puj24/EDL_TUE16/PID_Tuning/pocket-pcr.jpeg

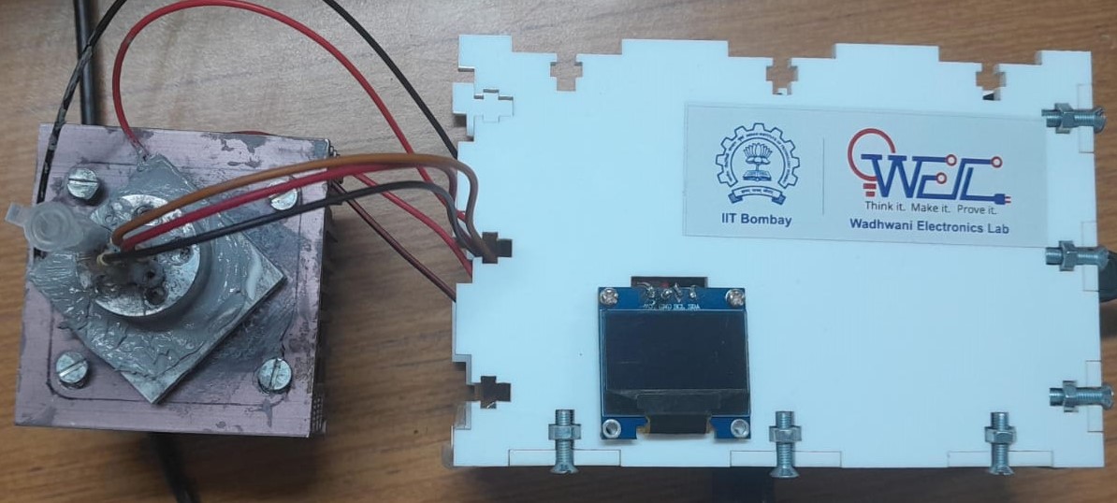
PID_Tuning/pocket-pcr.jpeg
