puj24/EDL_TUE16/Datasheets/Monochrome-OLED-display-2D-model.jpg

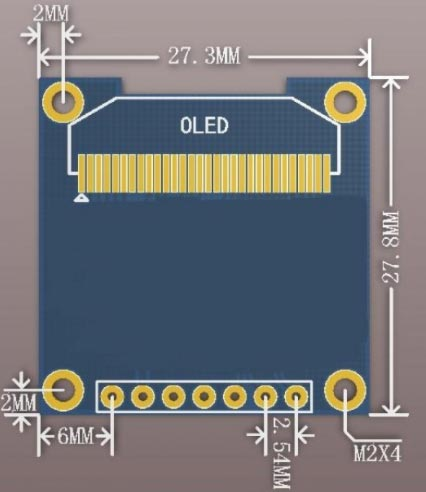
Datasheets/Monochrome-OLED-display-2D-model.jpg
