puj24/EDL_TUE16/CAD/LM35DZ.JPG

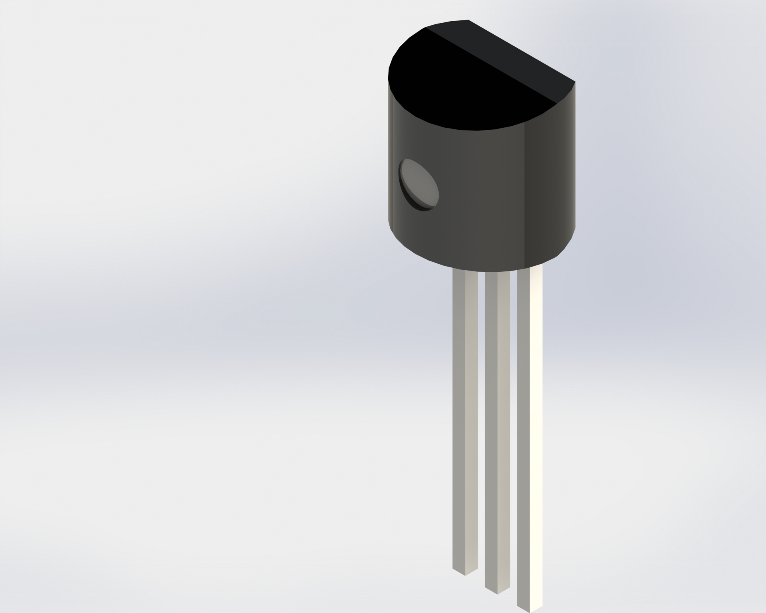
CAD/LM35DZ.JPG
