puj24/EDL_TUE16/Datasheets/Footprints-OLED128W_dims.jpg

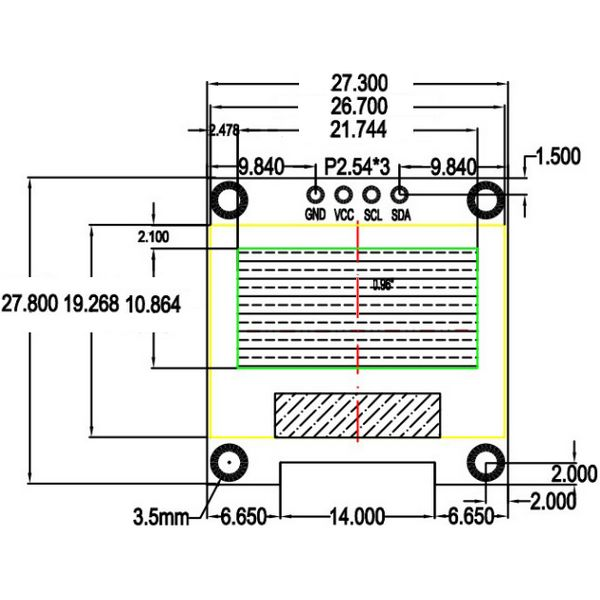
Datasheets/Footprints-OLED128W_dims.jpg
