puj24/EDL_TUE16/GANTT CHART.png

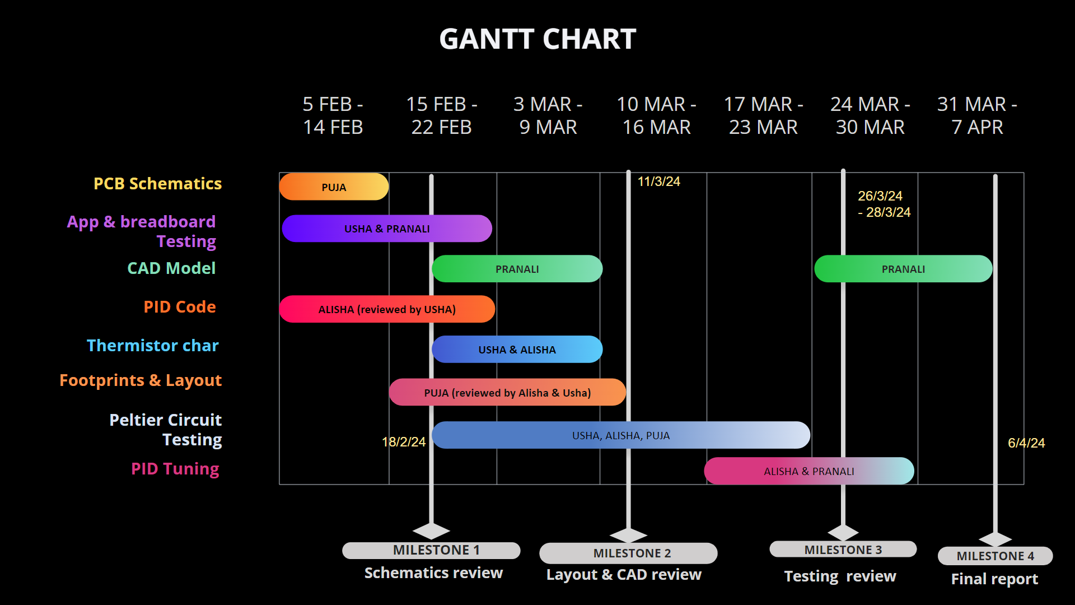
GANTT CHART.png
