puj24/EDL_TUE16/PCB_placement.png

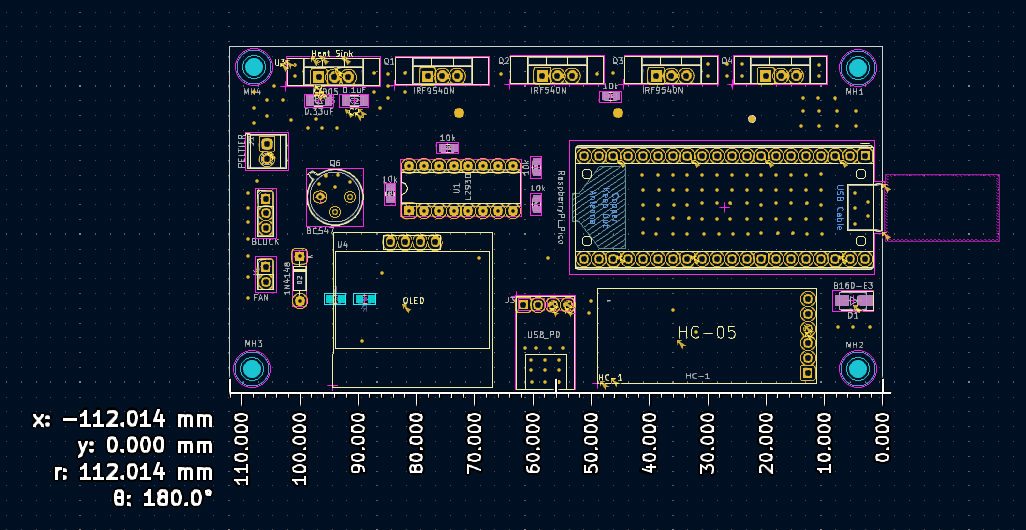
PCB_placement.png
