puj24/EDL_TUE16/CAD/vial 0.2ml.SLDPRT

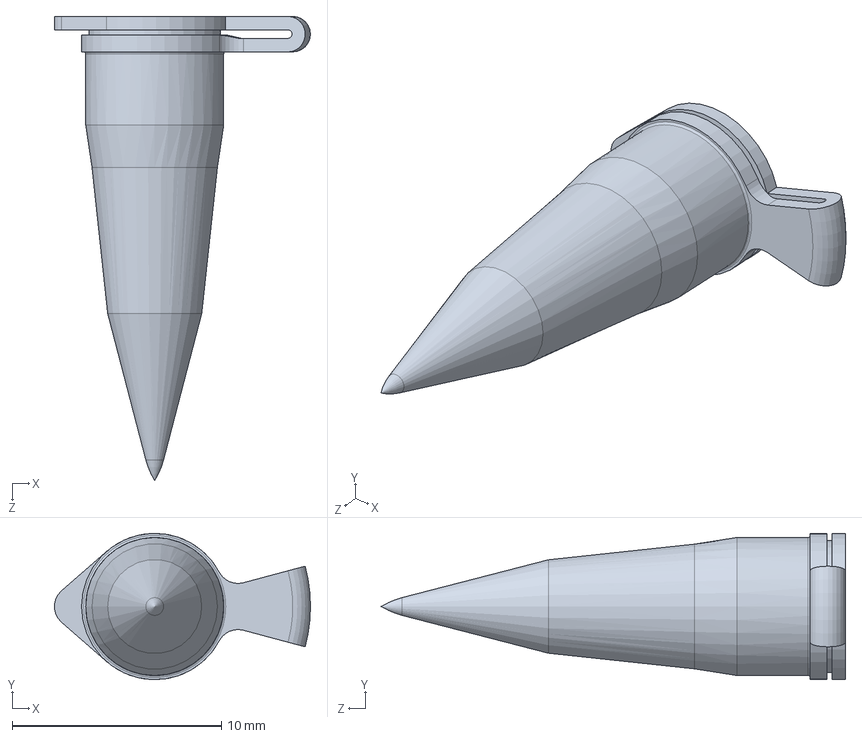
[picture p23: CAD file, 2024-06-16]
CAD/vial 0.2ml.SLDPRT
12.2 x 7.00 x 22.2 mm
