puj24/EDL_TUE16/CAD/box v4.dxf

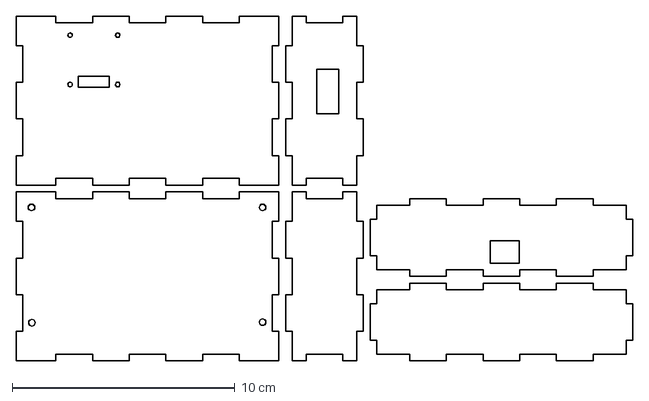
[picture p24: CAD file, 2024-06-16]
CAD/box v4.dxf
27.7 x 15.5 cm
