puj24/EDL_TUE16/(list of files, cad)

Other CAD files:
CAD/PCR_Heater v4.f3d
