puj24/EDL_TUE16/PID_Tuning/1.png

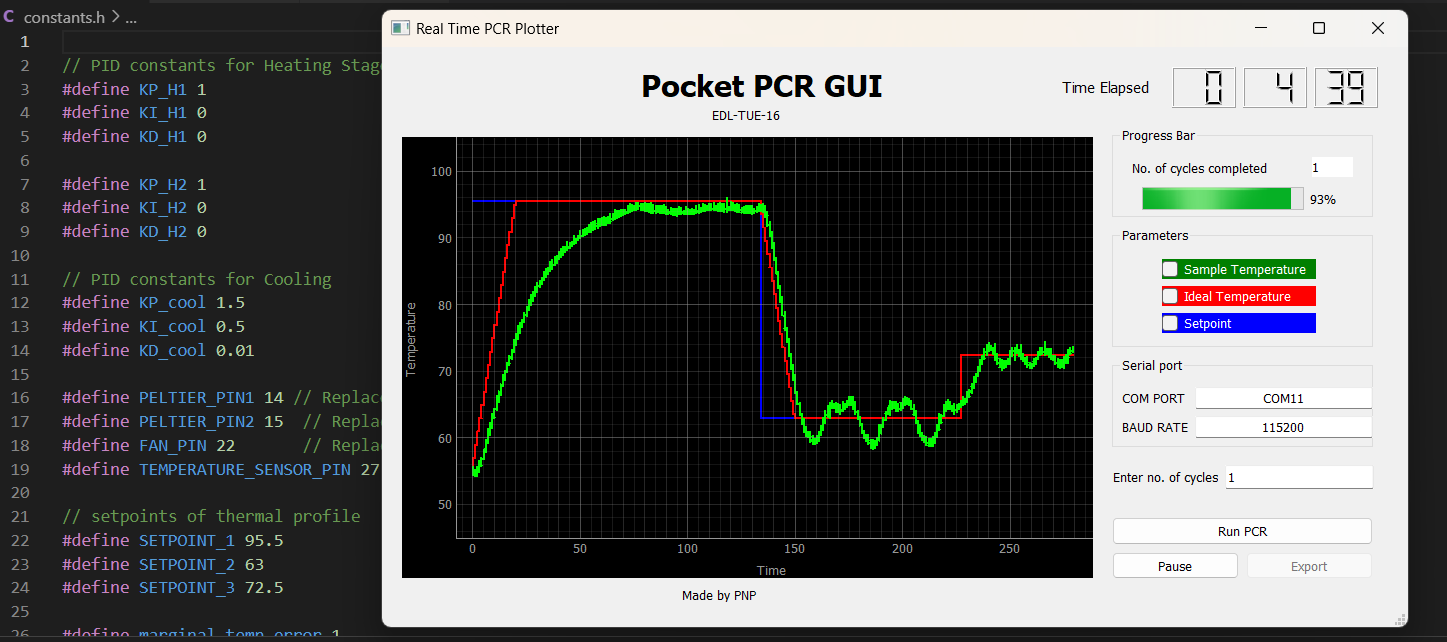
PID_Tuning/1.png
