puj24/EDL_TUE16/PID_Tuning/2.png

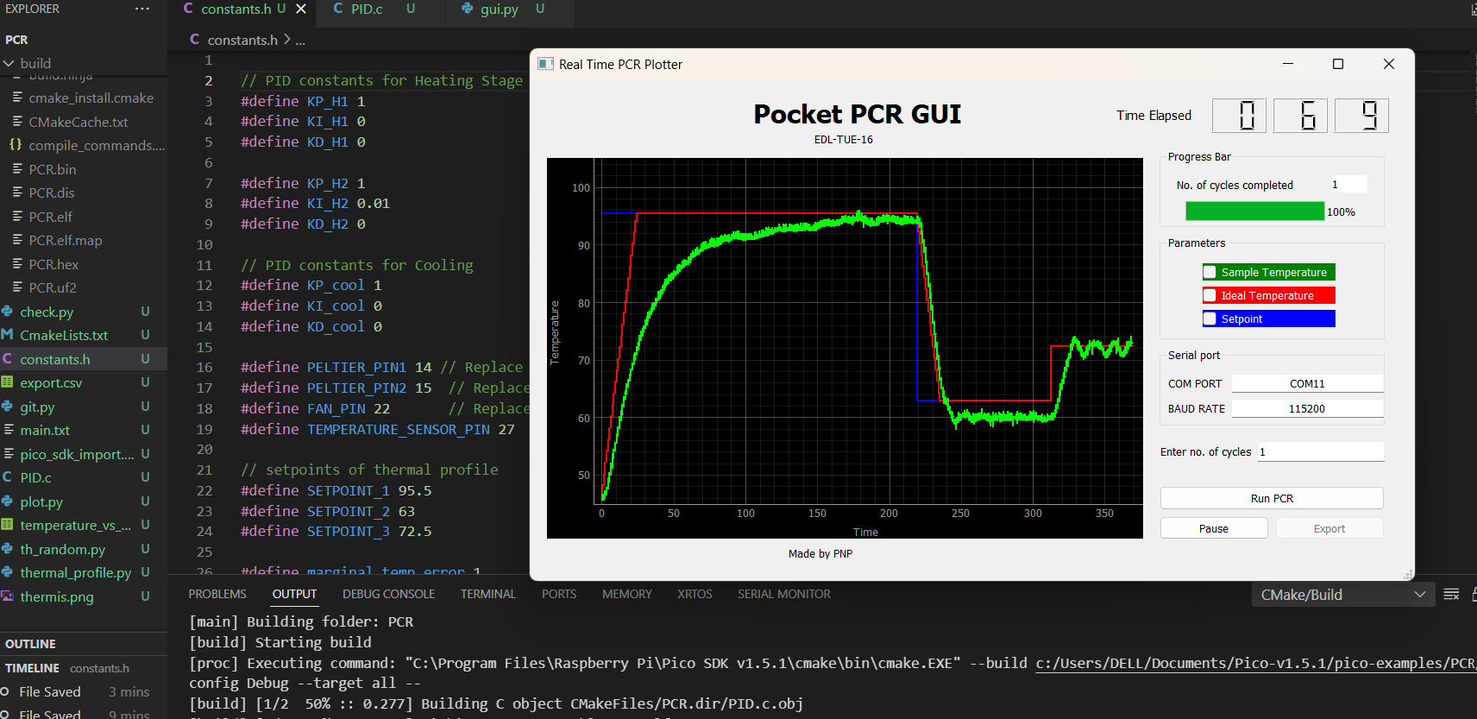
PID_Tuning/2.png
