puj24/EDL_TUE16/PID_Tuning/3.png

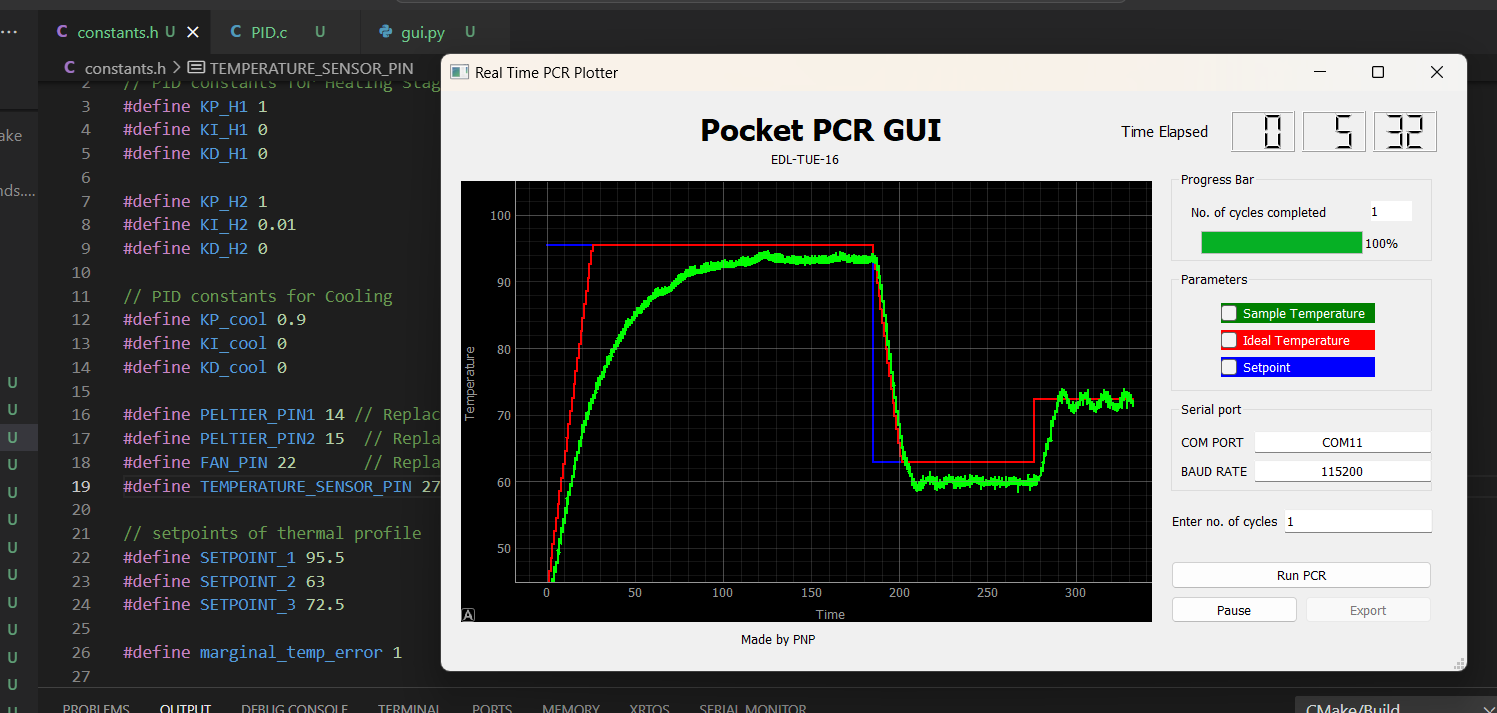
PID_Tuning/3.png
