puj24/EDL_TUE16/PID_Tuning/4.png

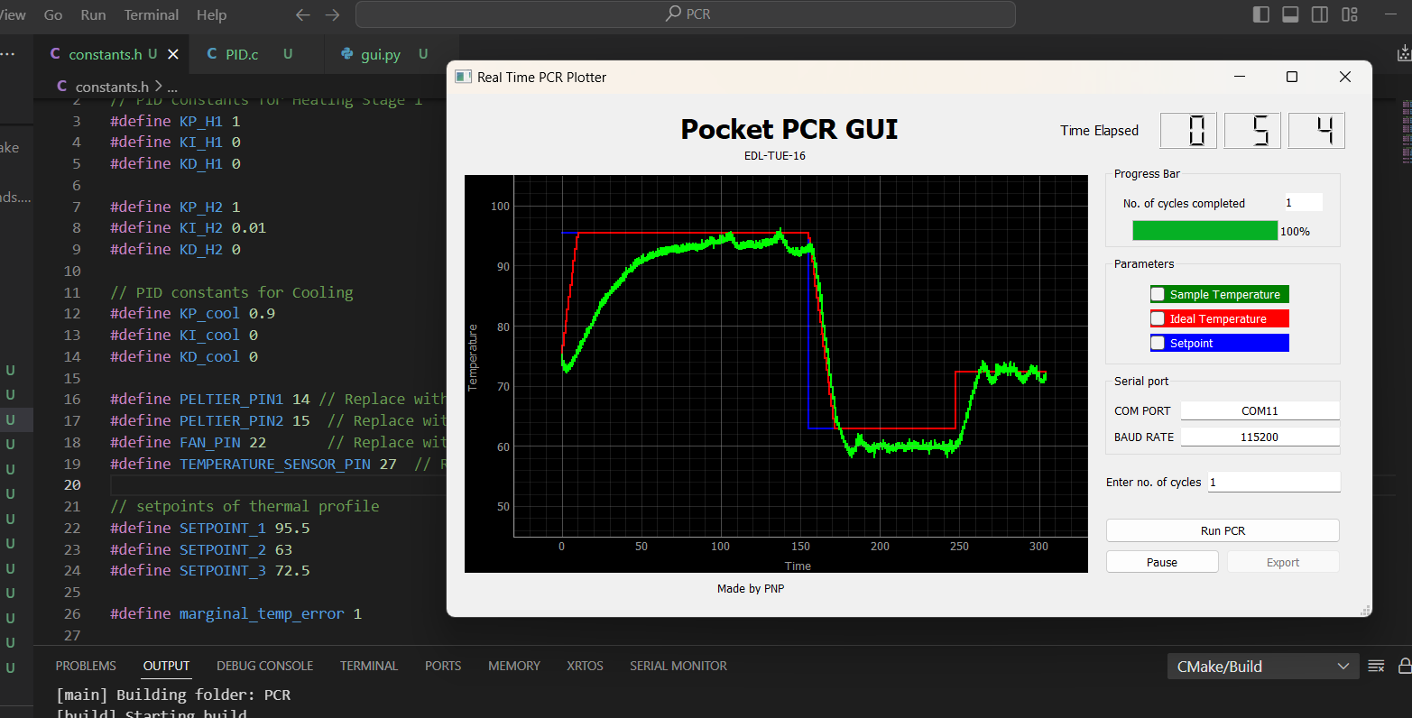
PID_Tuning/4.png
