puj24/EDL_TUE16/PID_Tuning/5.png

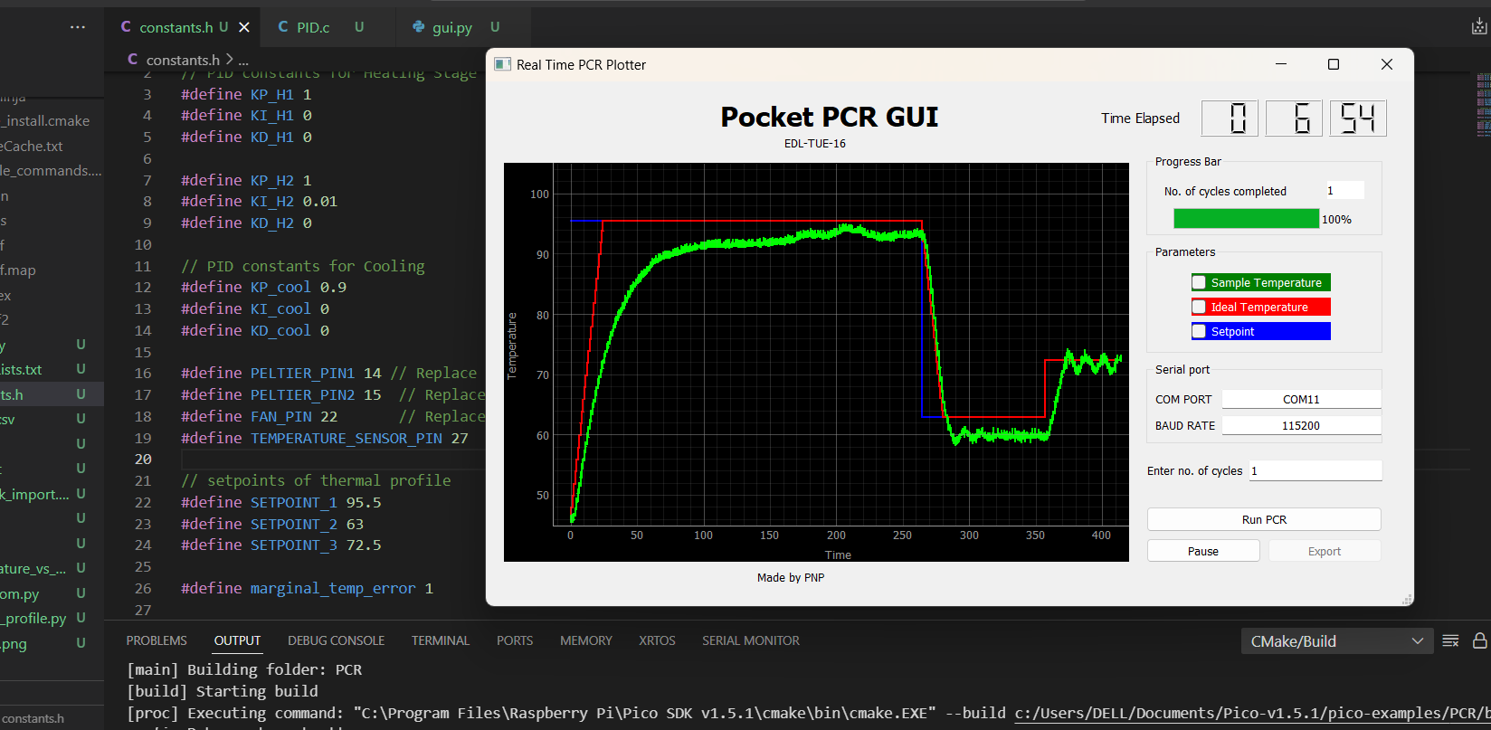
PID_Tuning/5.png
