puj24/EDL_TUE16/PID_Tuning/6.png

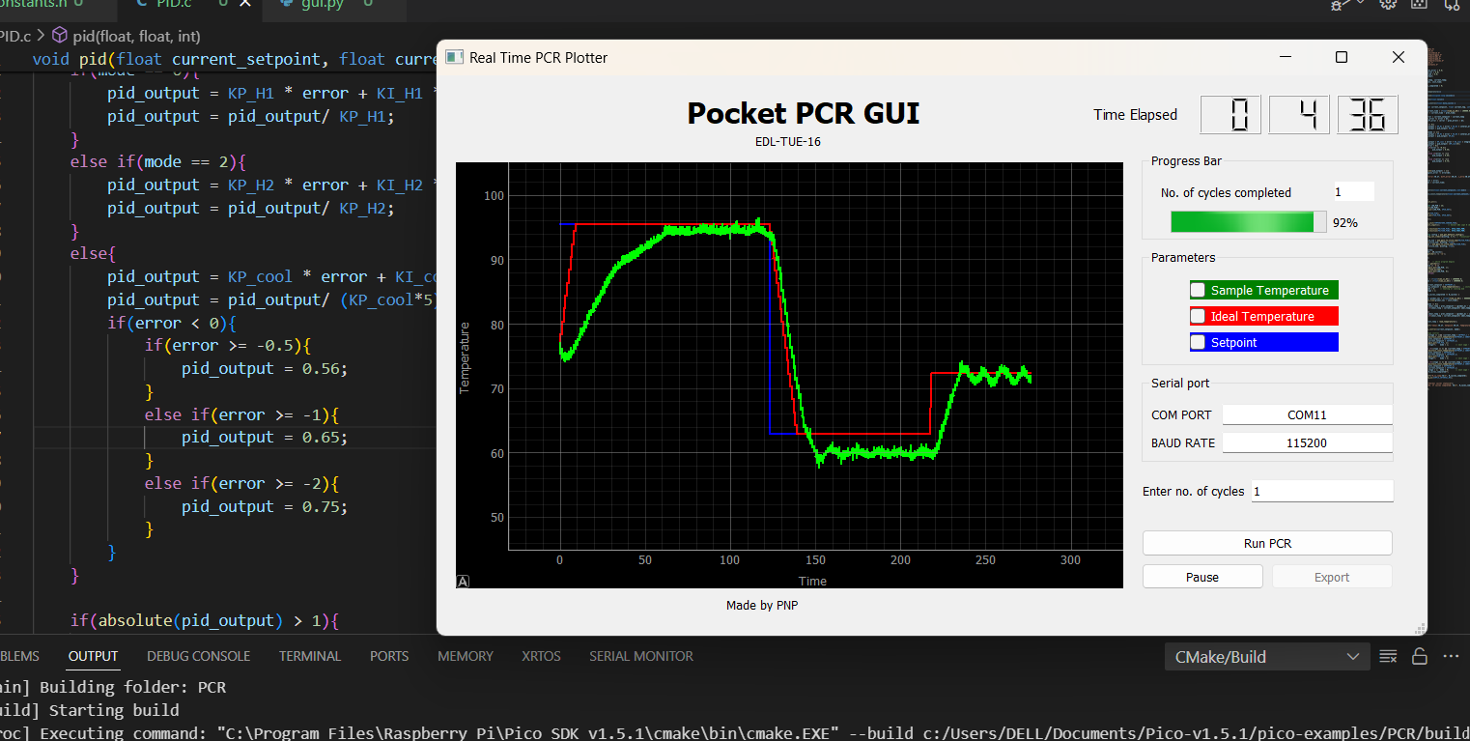
PID_Tuning/6.png
