puj24/EDL_TUE16/PID_Tuning/7.png

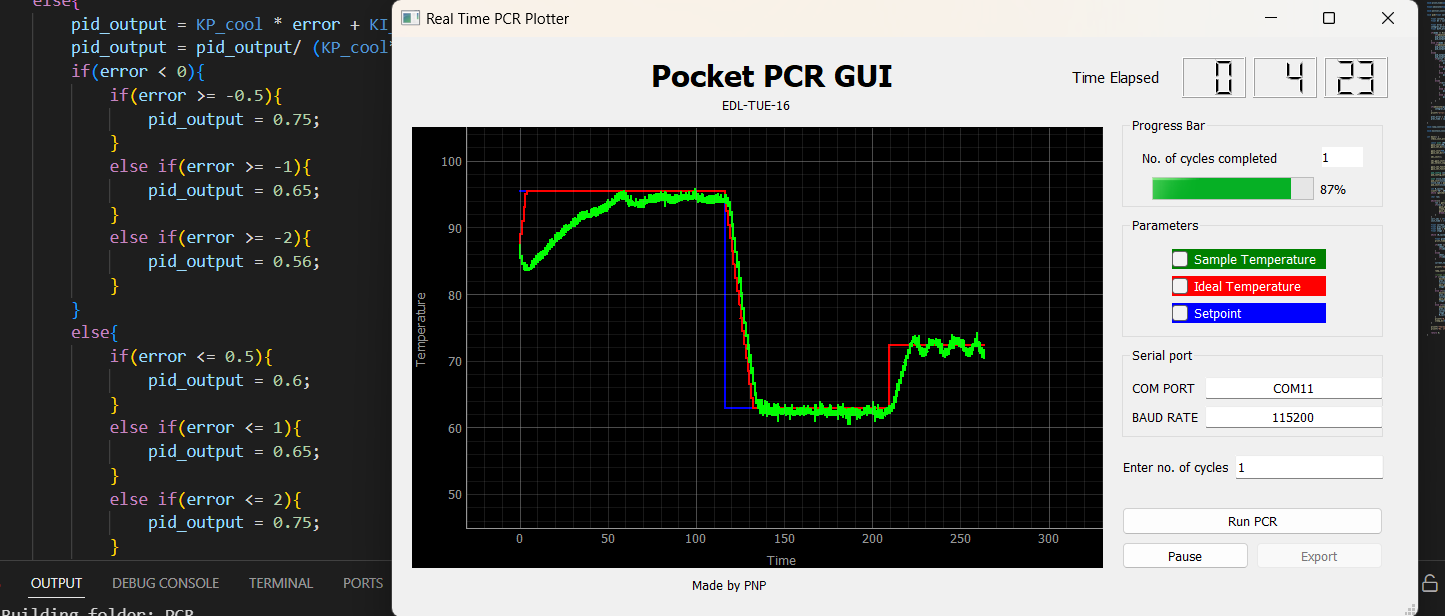
PID_Tuning/7.png
