puj24/EDL_TUE16/PID_Tuning/8.png

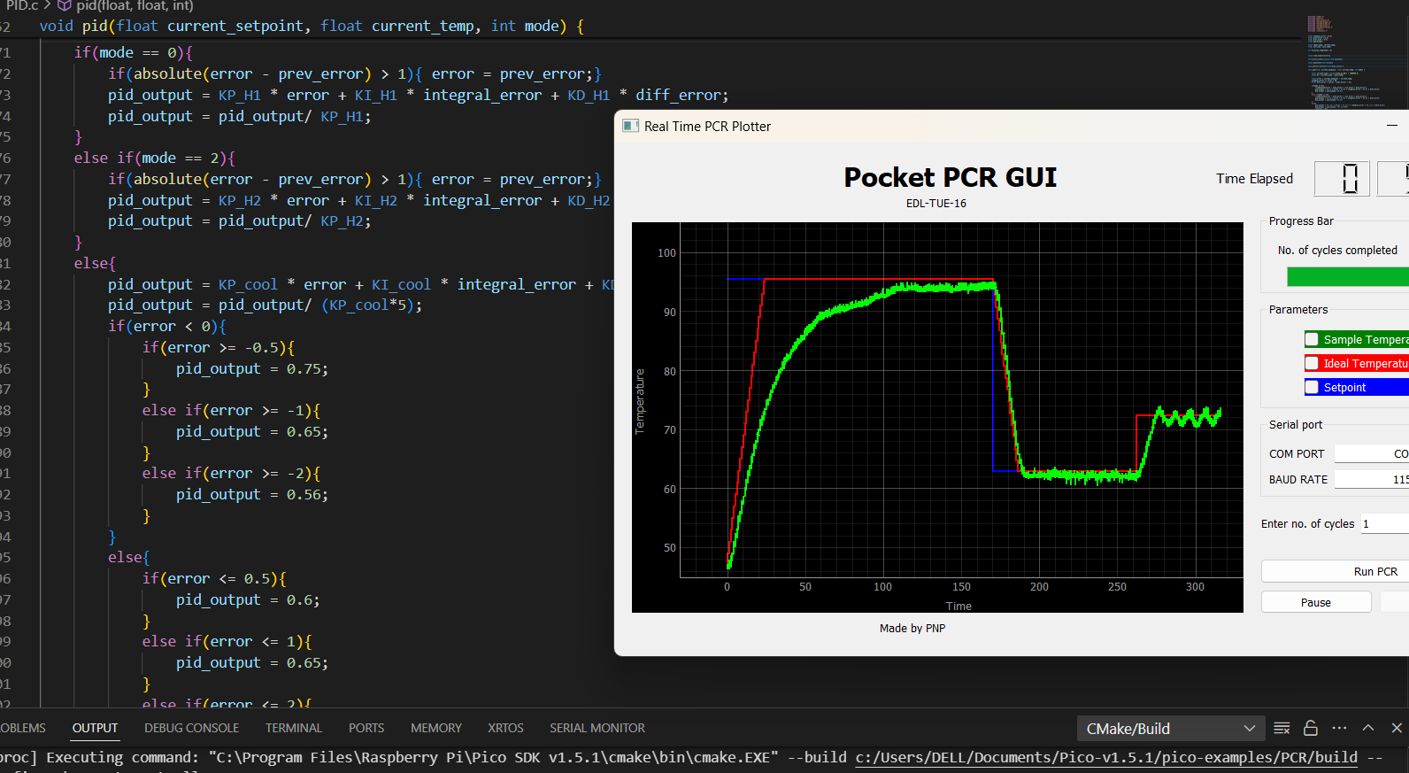
PID_Tuning/8.png
