puj24/EDL_TUE16/PID_Tuning/9.png

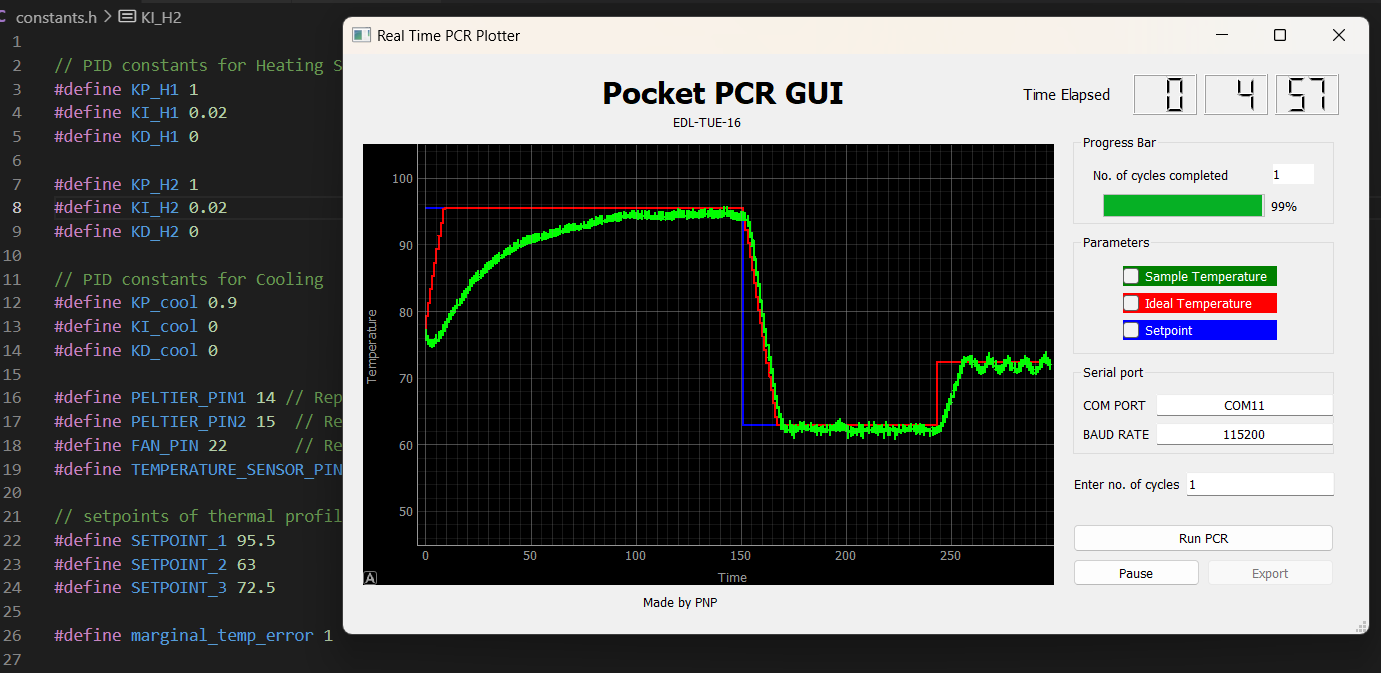
PID_Tuning/9.png
