puj24/EDL_TUE16/PID_Tuning/10.png

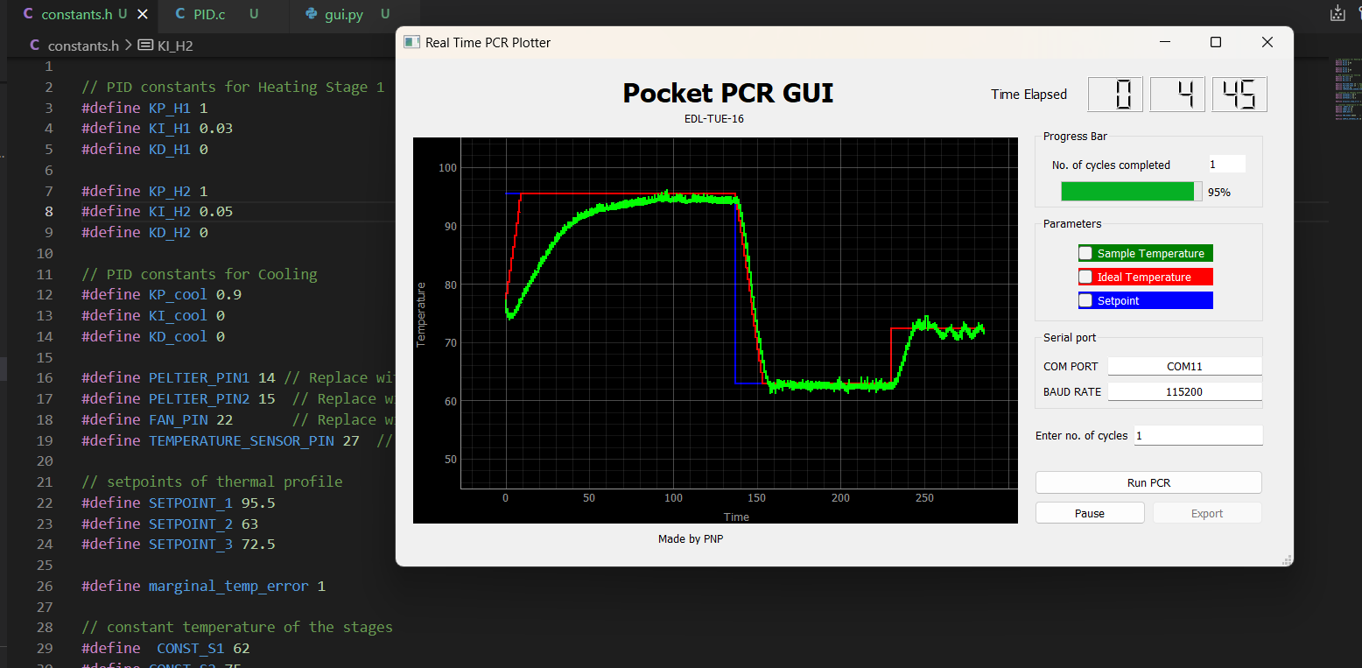
PID_Tuning/10.png
