puj24/EDL_TUE16/PID_Tuning/11.png

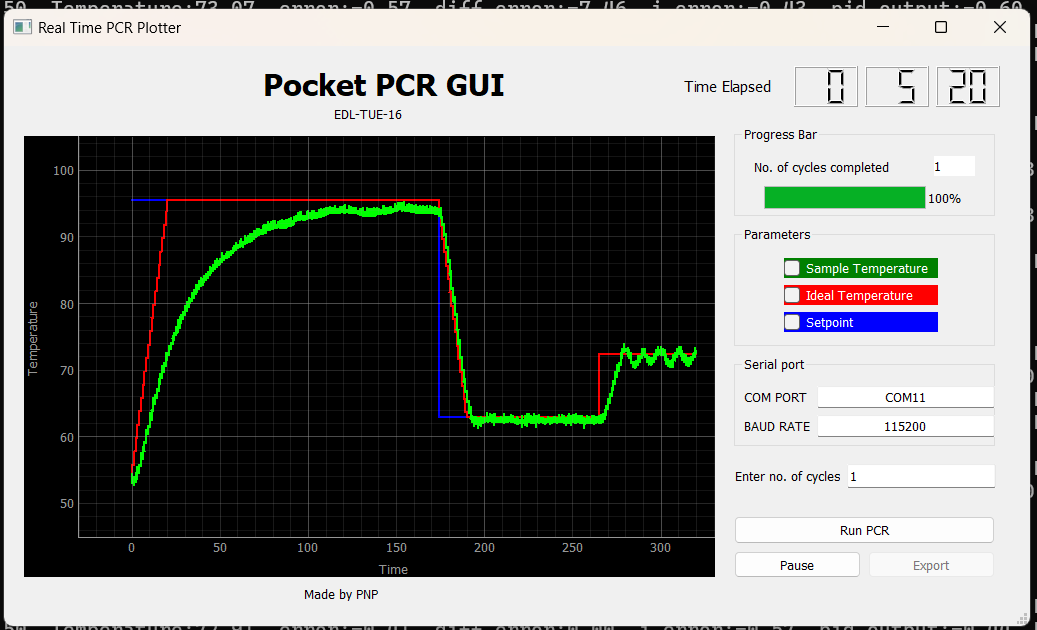
PID_Tuning/11.png
