puj24/EDL_TUE16/PID_Tuning/12.png

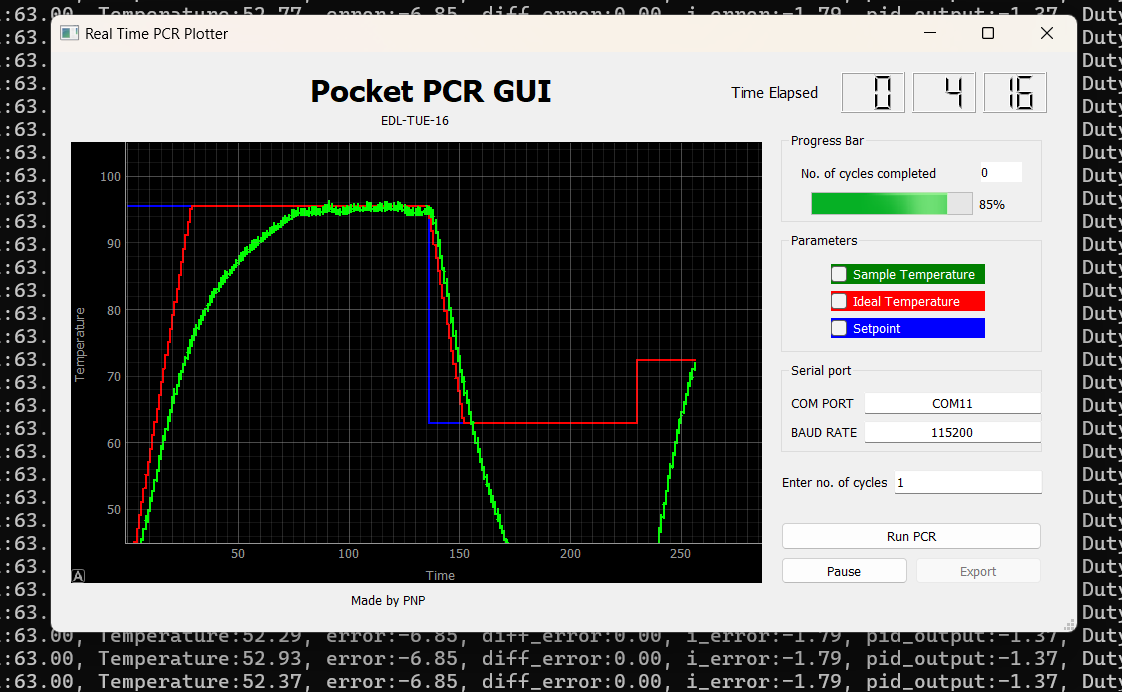
PID_Tuning/12.png
