puj24/EDL_TUE16/PID_Tuning/13.png

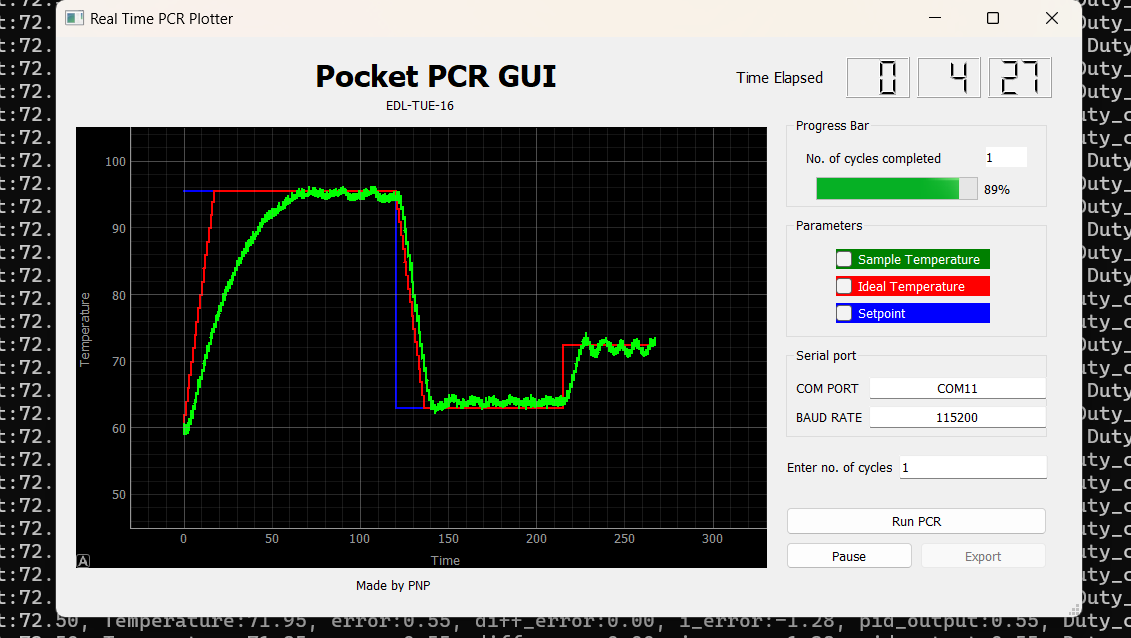
PID_Tuning/13.png
