puj24/EDL_TUE16/PID_Tuning/14.png

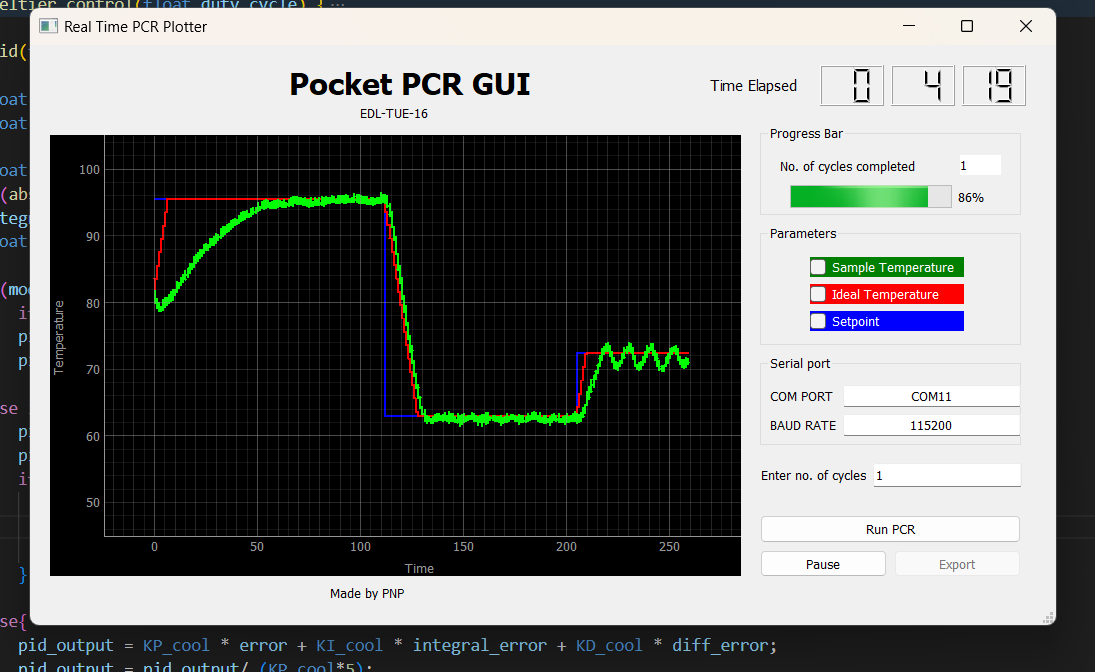
PID_Tuning/14.png
