puj24/EDL_TUE16/PID_Tuning/16.png

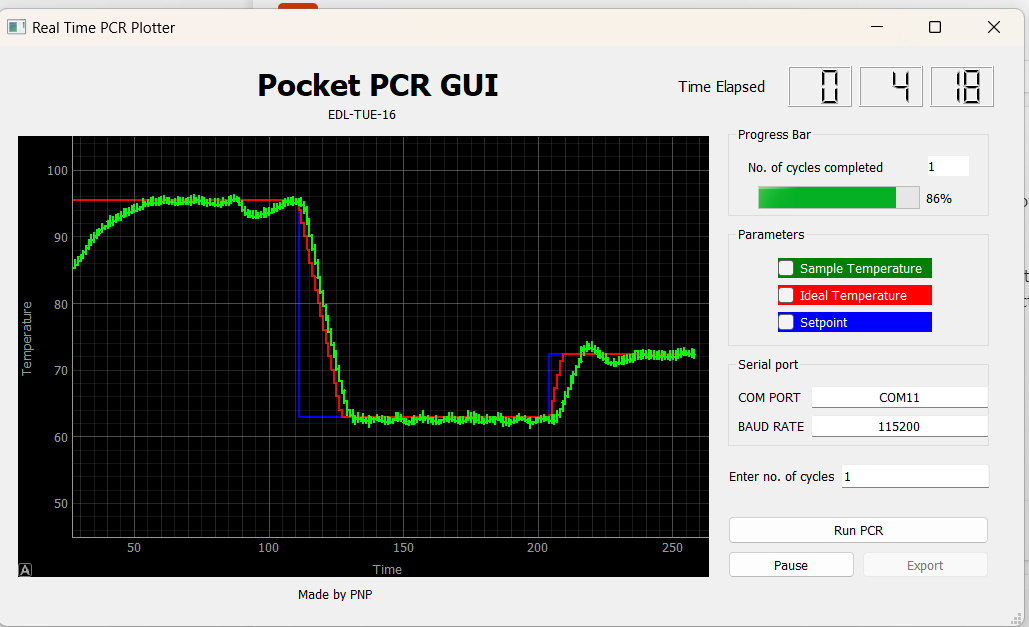
PID_Tuning/16.png
