puj24/EDL_TUE16/PID_Tuning/19.png

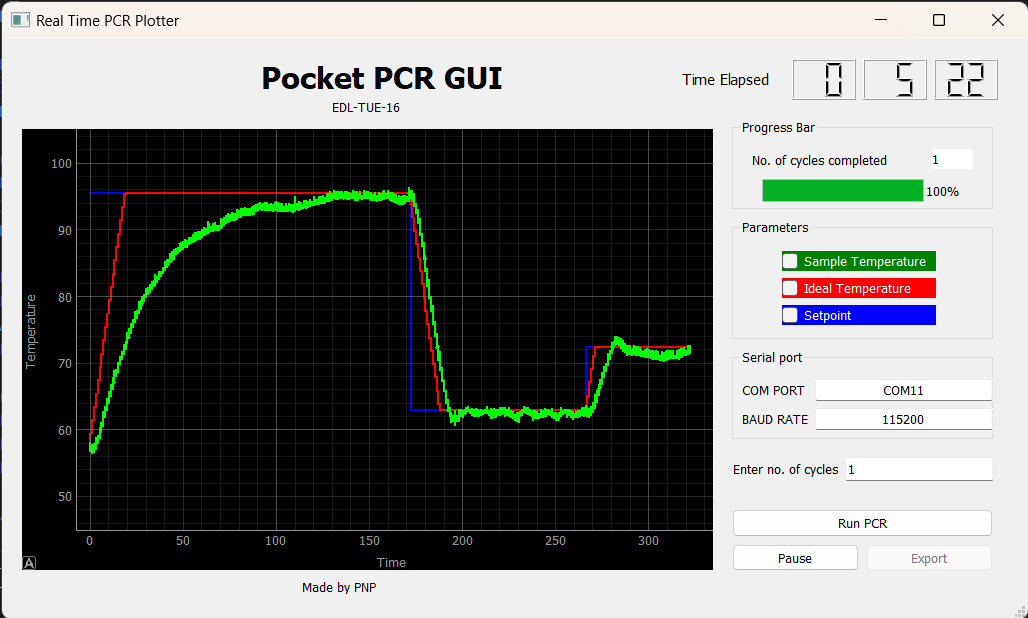
PID_Tuning/19.png
