puj24/EDL_TUE16/PID_Tuning/24.png

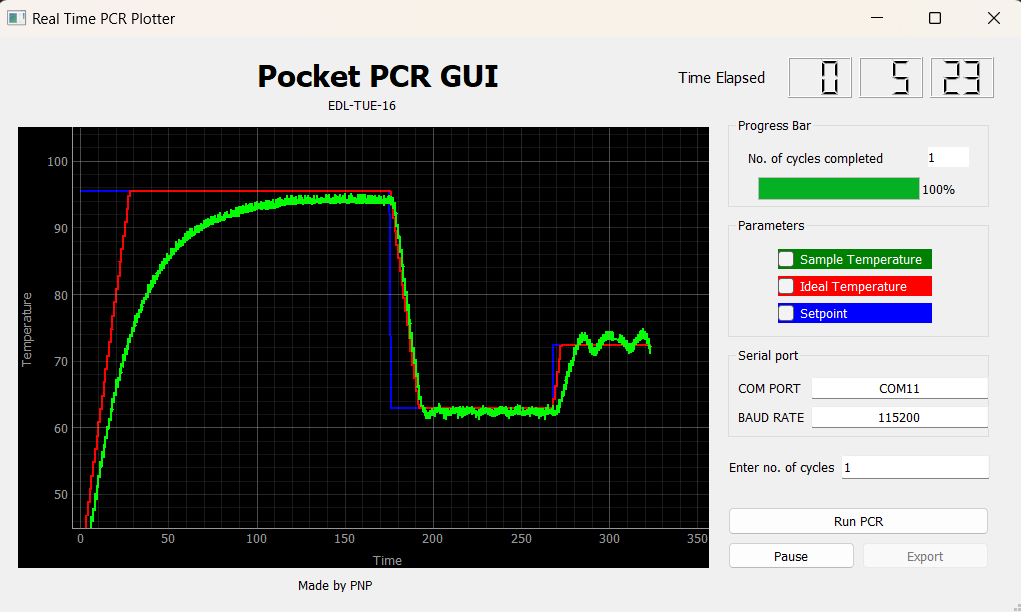
PID_Tuning/24.png
