puj24/EDL_TUE16/PID_Tuning/25.png

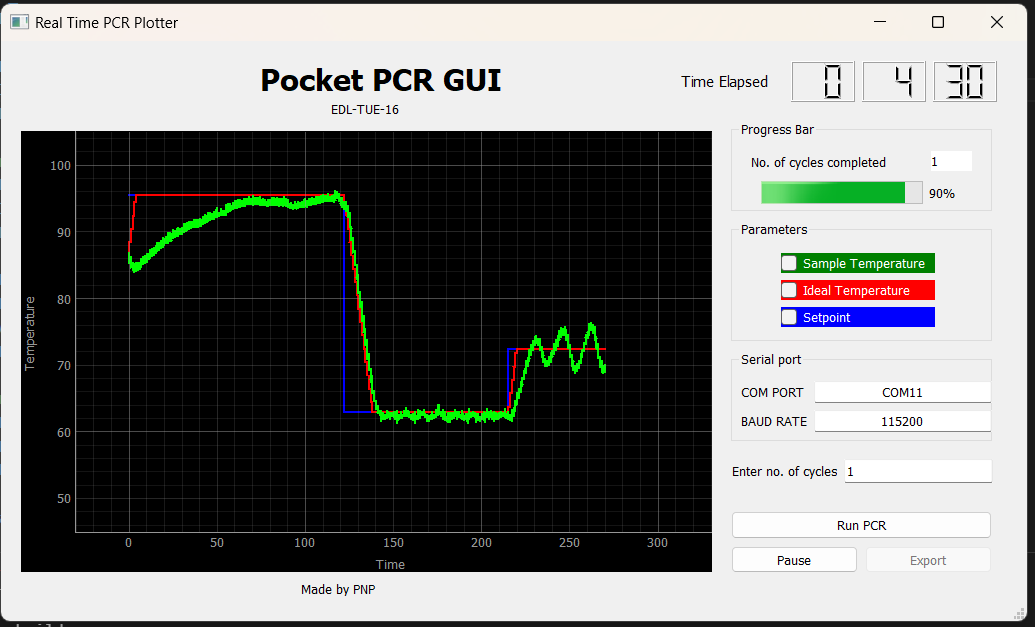
PID_Tuning/25.png
