puj24/EDL_TUE16/PID_Tuning/26.png

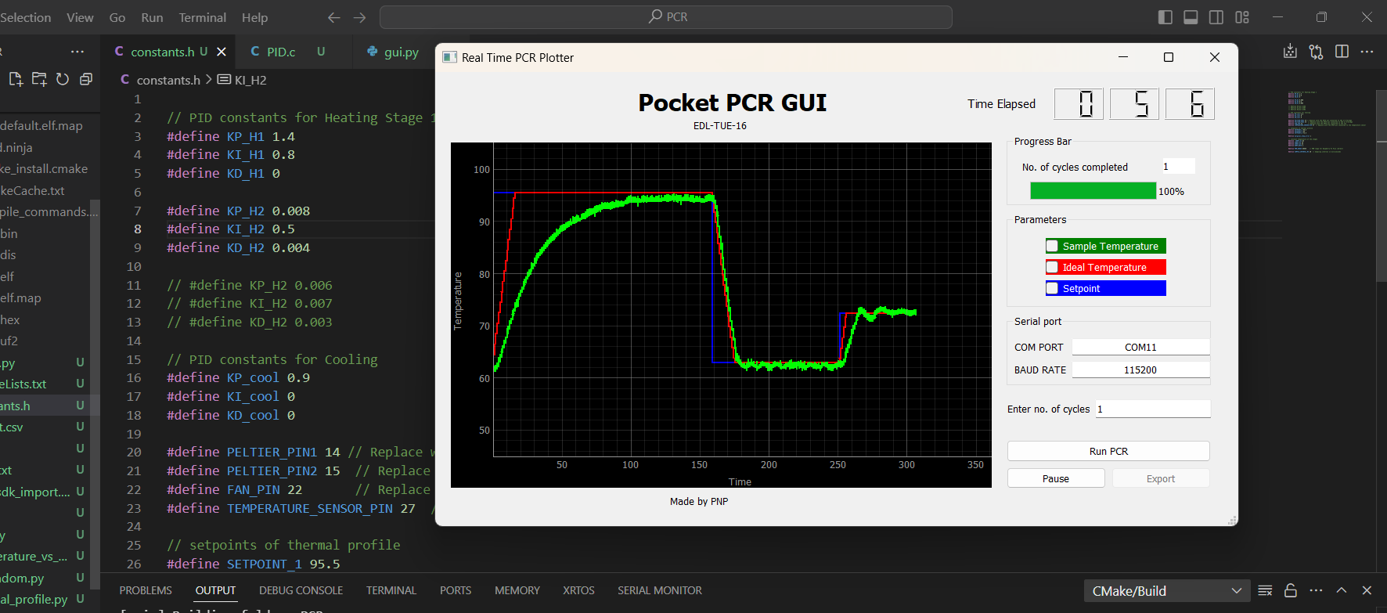
PID_Tuning/26.png
