puj24/EDL_TUE16/PID_Tuning/27.png

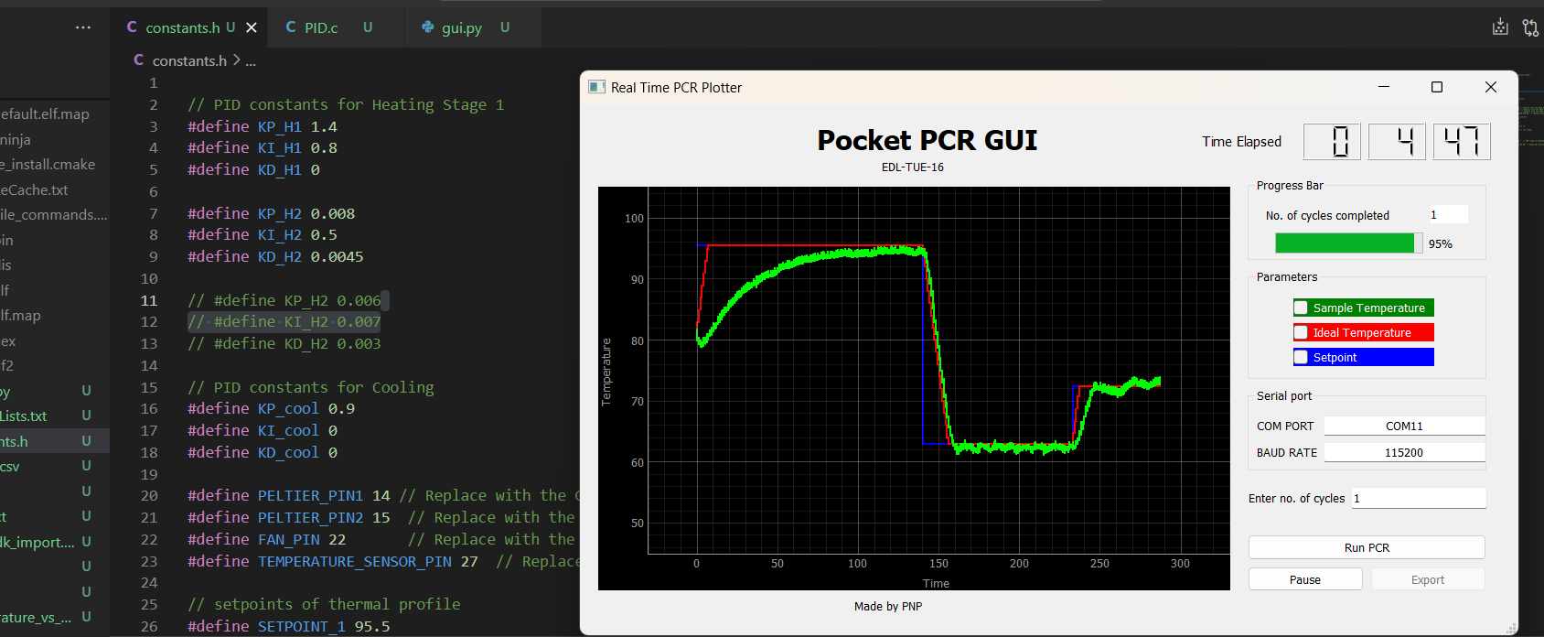
PID_Tuning/27.png
