puj24/EDL_TUE16/PID_Tuning/28.png

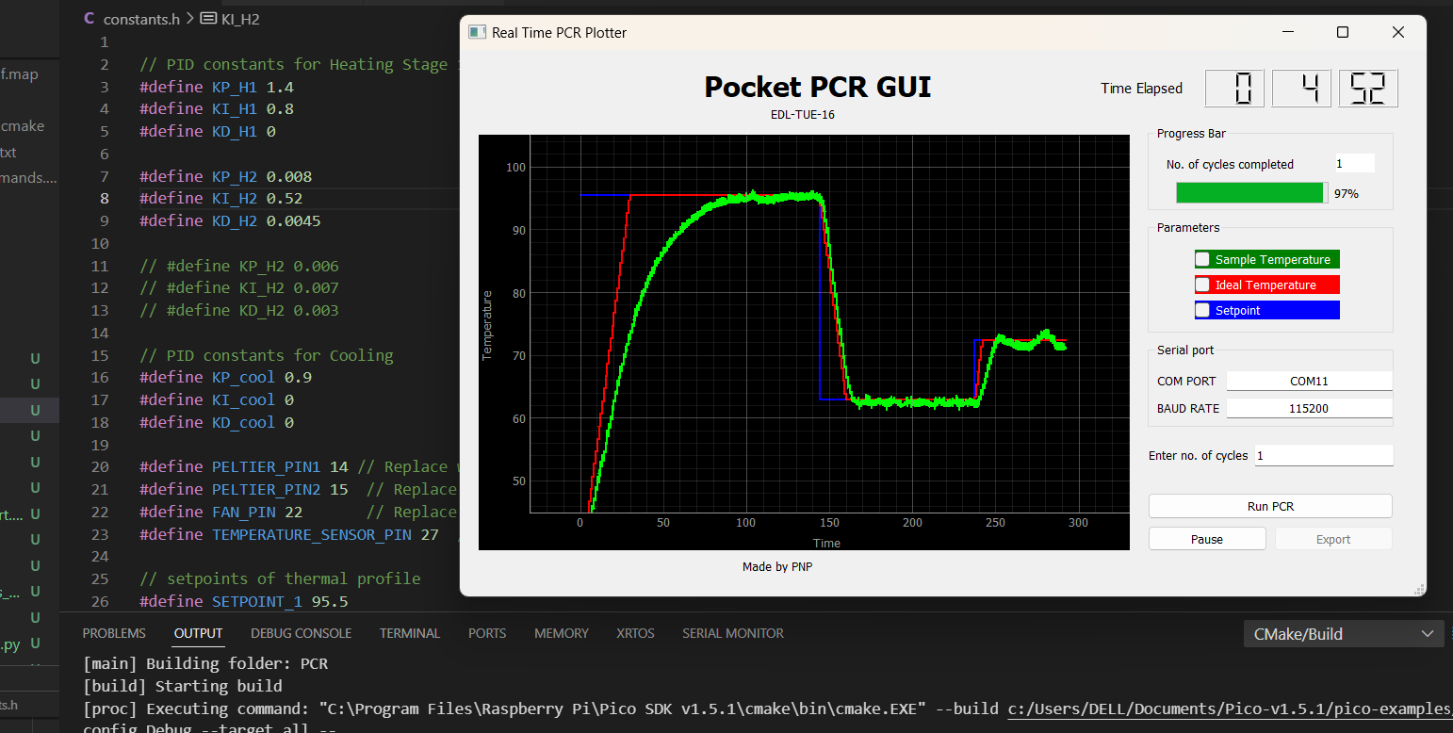
PID_Tuning/28.png
