puj24/EDL_TUE16/PID_Tuning/pid_tuning_h1_kp_1.1_ki_0.075.png

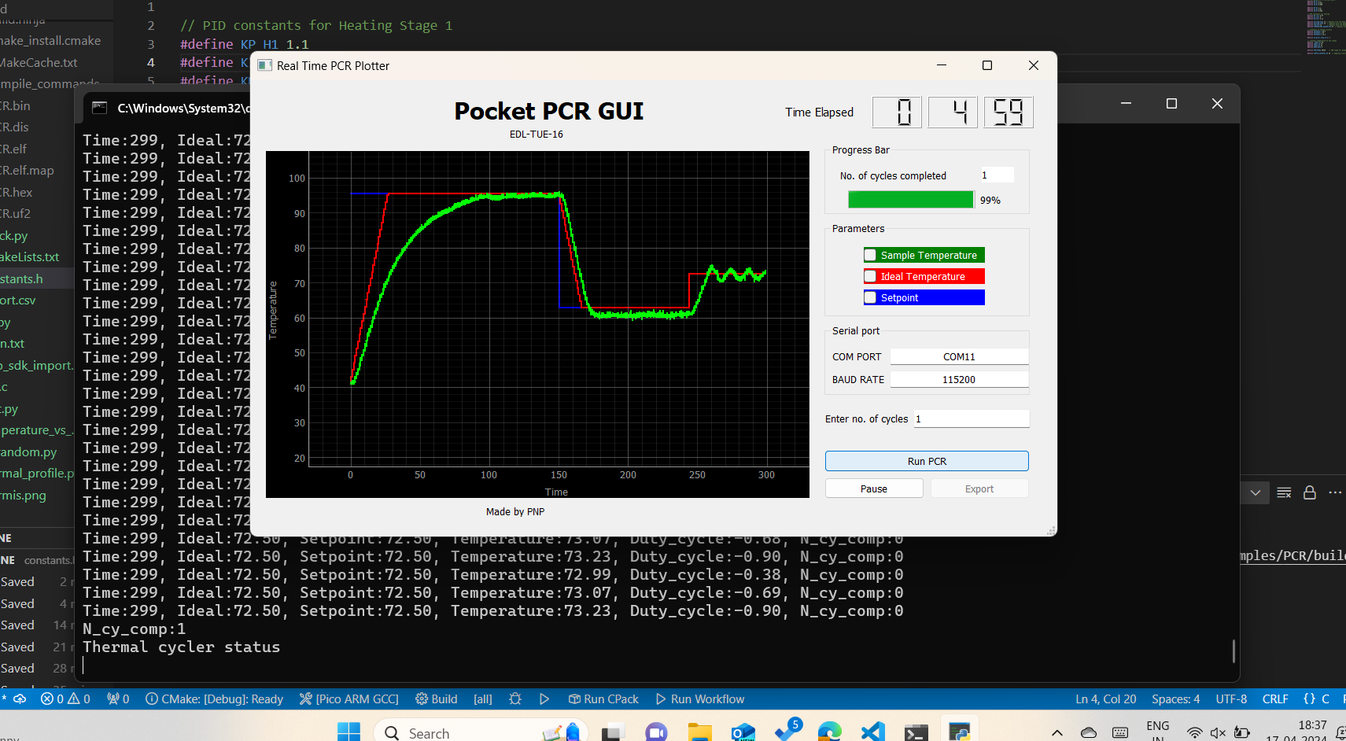
PID_Tuning/pid_tuning_h1_kp_1.1_ki_0.075.png
