puj24/EDL_TUE16/PID_Tuning/pid_tuning_h2_kp_1.1_ki_0.076_kd_0.01.png

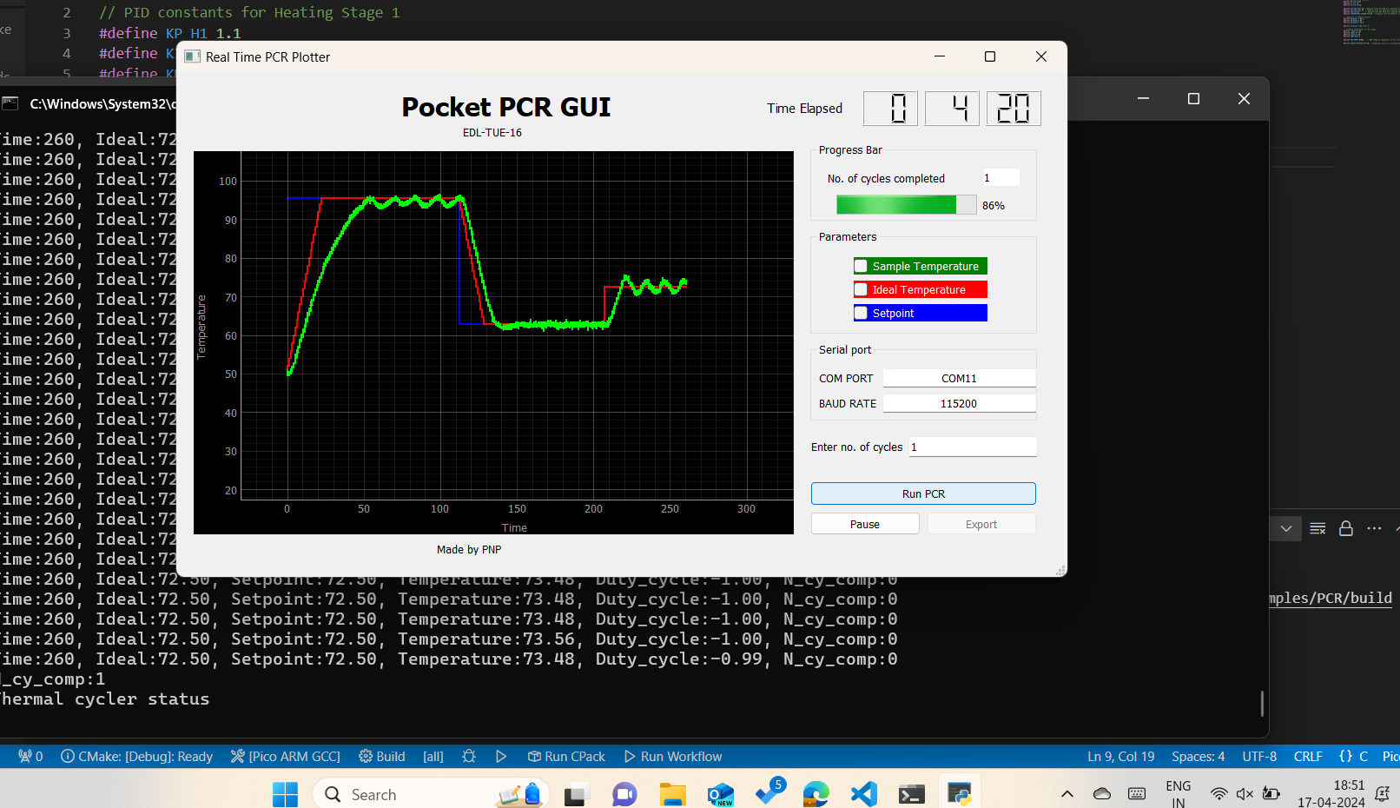
PID_Tuning/pid_tuning_h2_kp_1.1_ki_0.076_kd_0.01.png
