puj24/EDL_TUE16/PID_Tuning/pid_tuning_kp_0.8.png

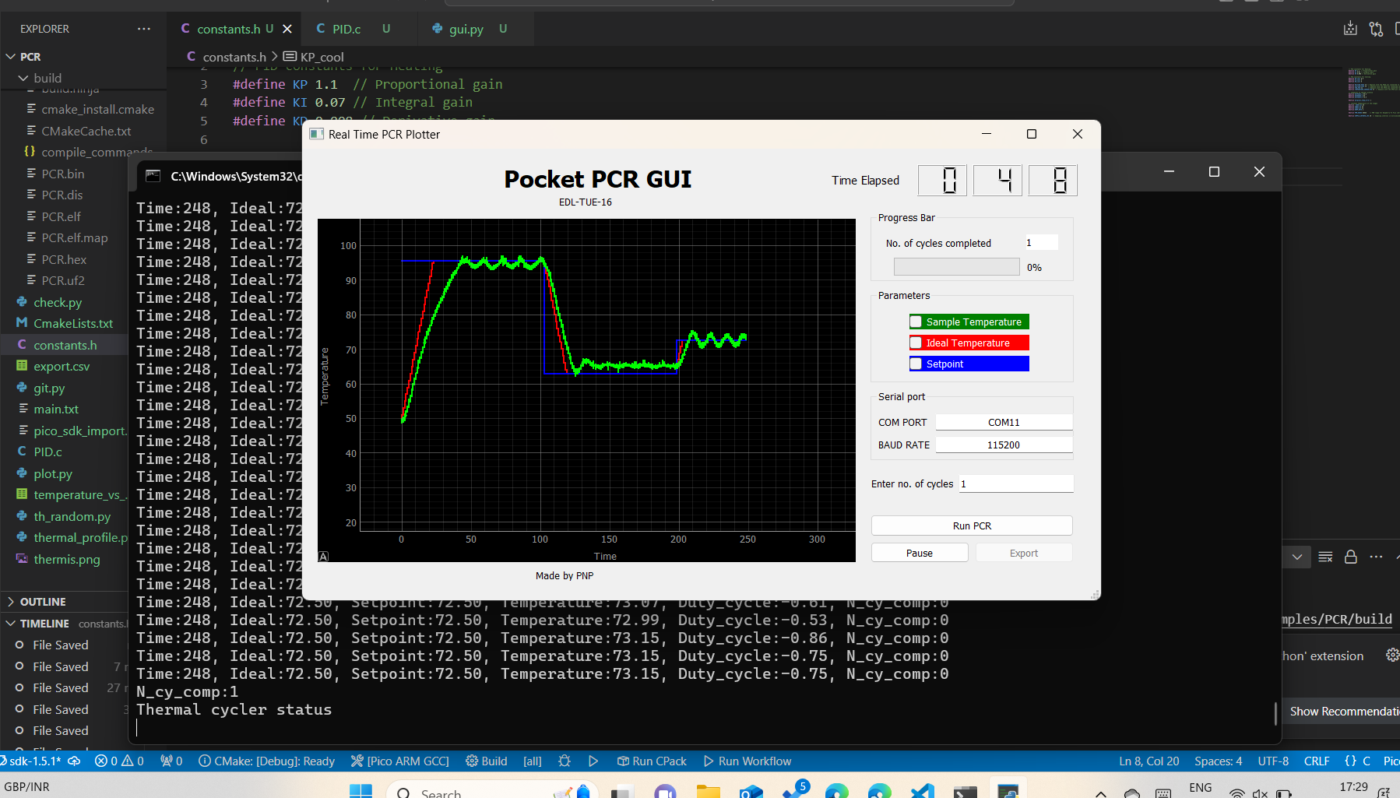
PID_Tuning/pid_tuning_kp_0.8.png
