puj24/EDL_TUE16/PID_Tuning/pid_tuning_kp_0.9.png

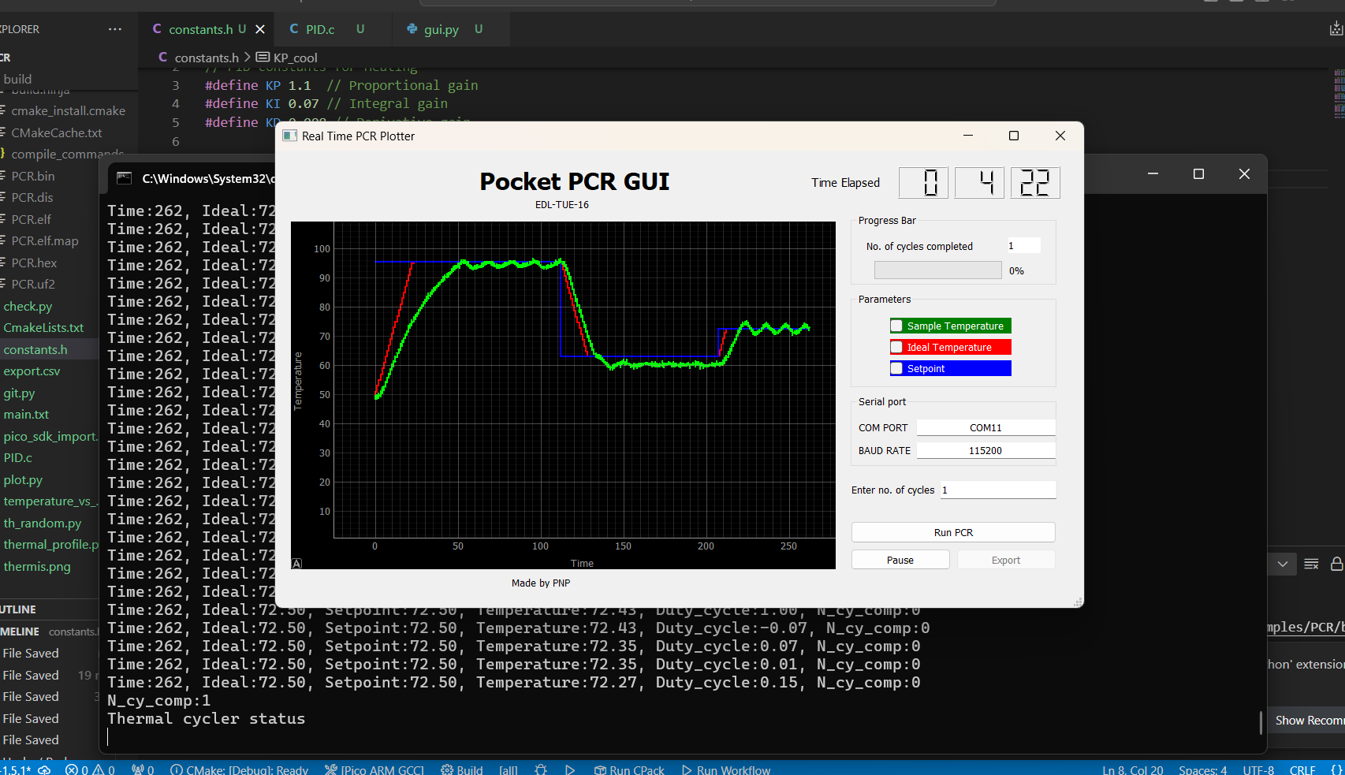
PID_Tuning/pid_tuning_kp_0.9.png
