puj24/EDL_TUE16/PID_Tuning/pid_tuning_kp_0.85_kd_0.01.png

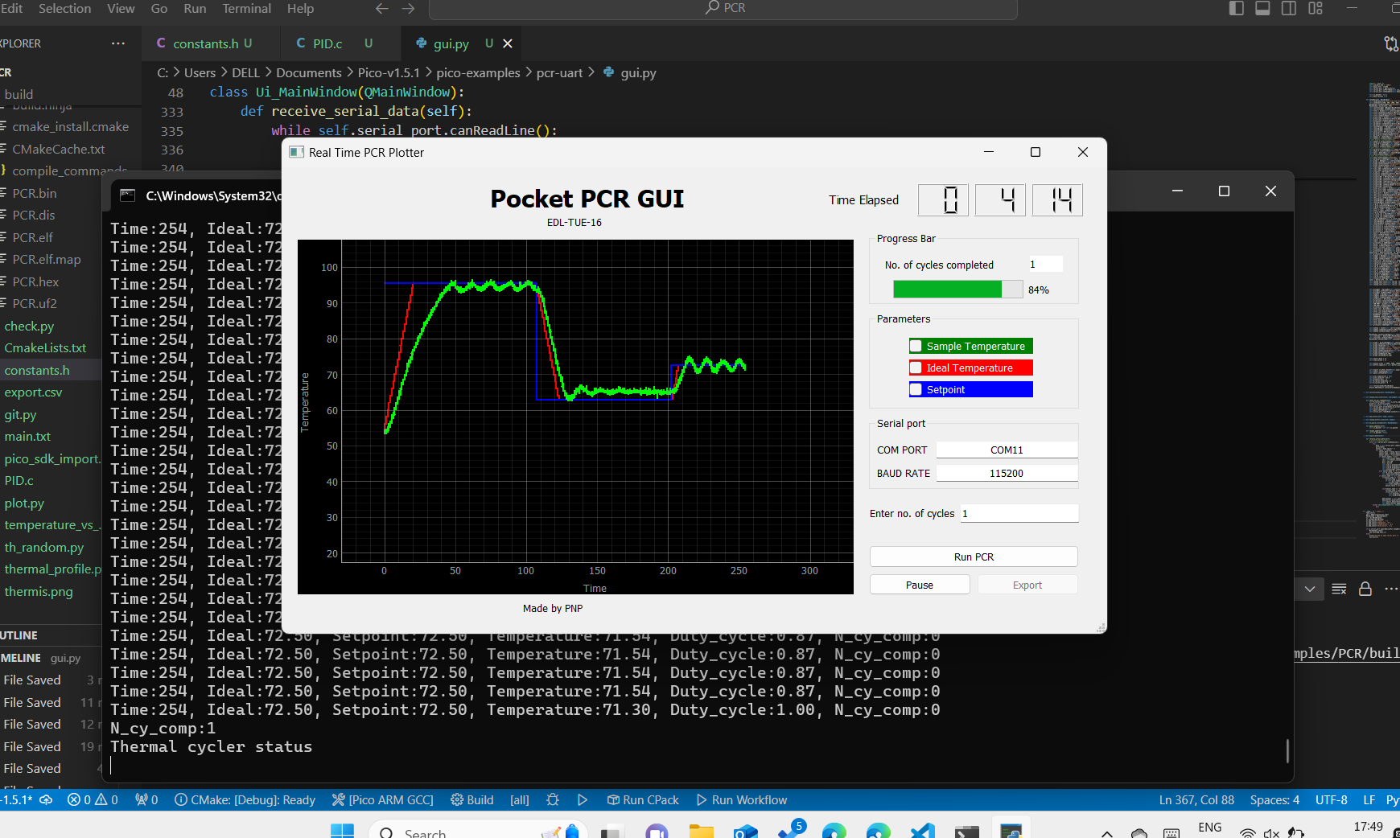
PID_Tuning/pid_tuning_kp_0.85_kd_0.01.png
