puj24/EDL_TUE16/PID_Tuning/pid_tuning_kp_0.87_kd_0.15.png

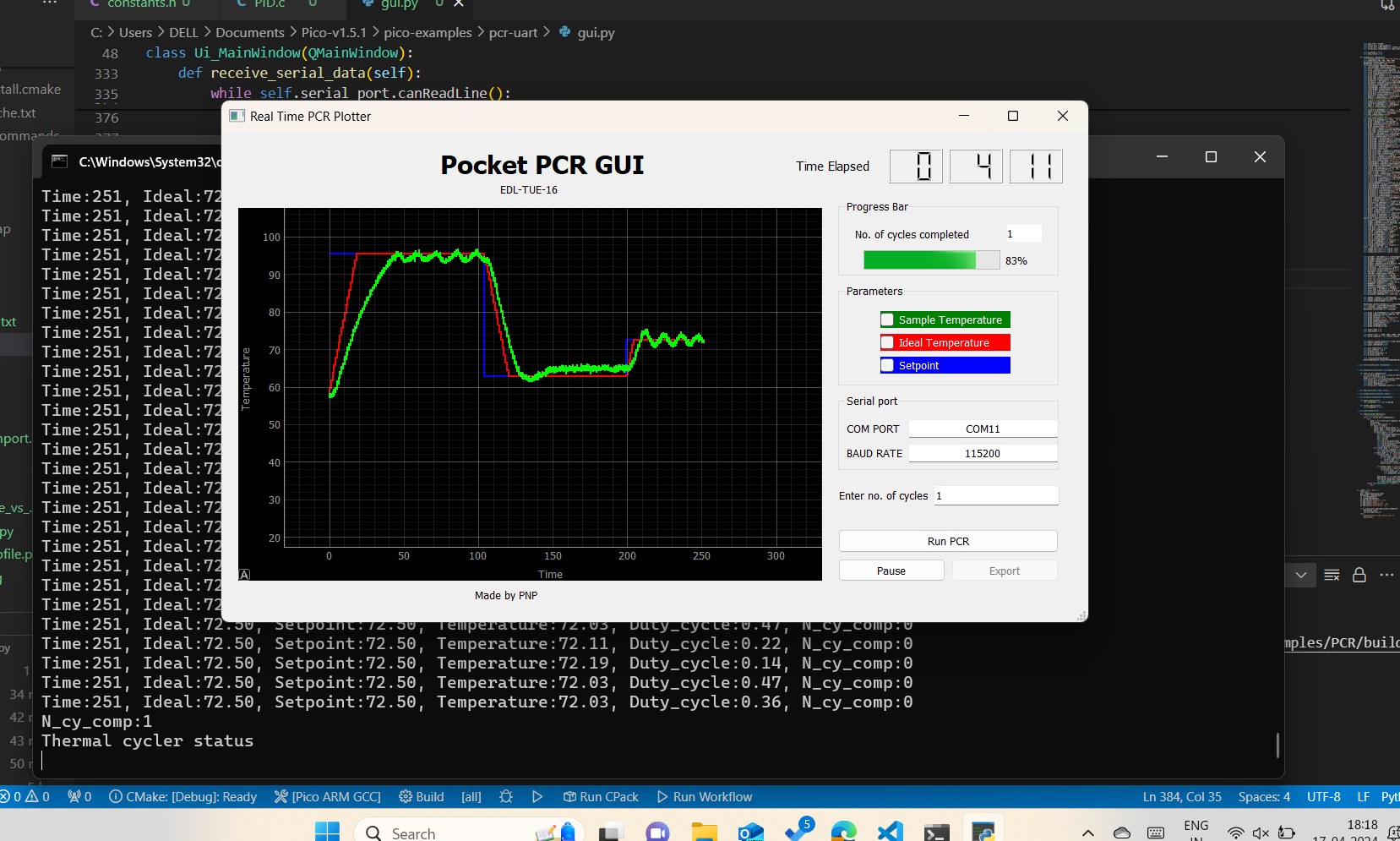
PID_Tuning/pid_tuning_kp_0.87_kd_0.15.png
