puj24/EDL_TUE16/EDL-RETURN-COMPONENTS.pdf

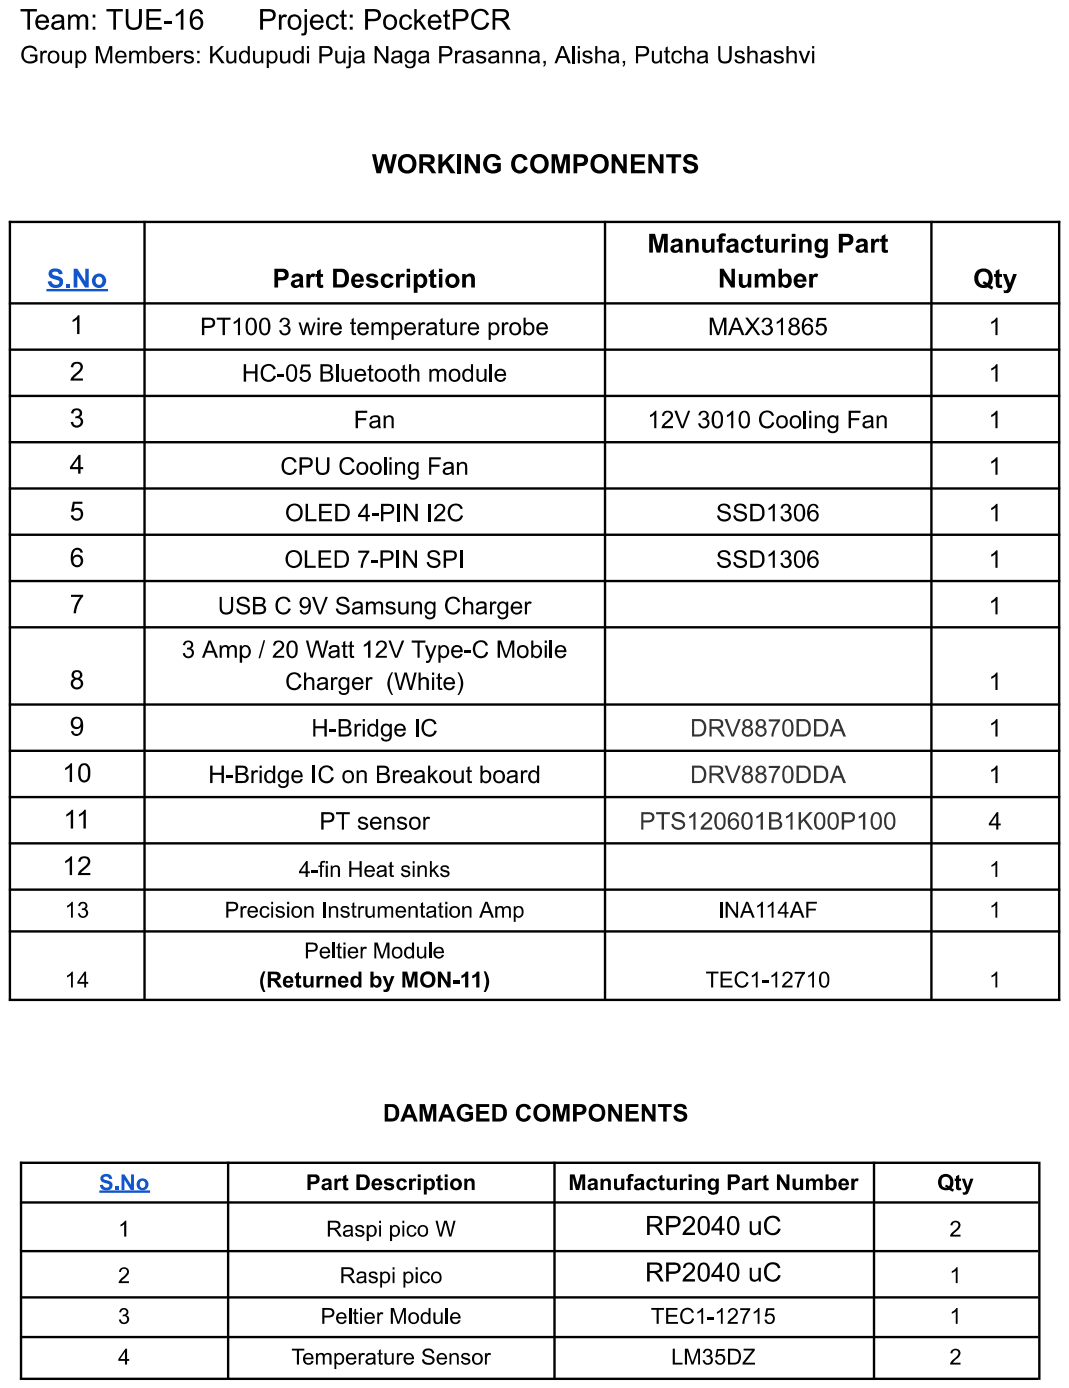
[picture p57: page 1]
