puj24/EDL_TUE16/PCB_Schematics.pdf

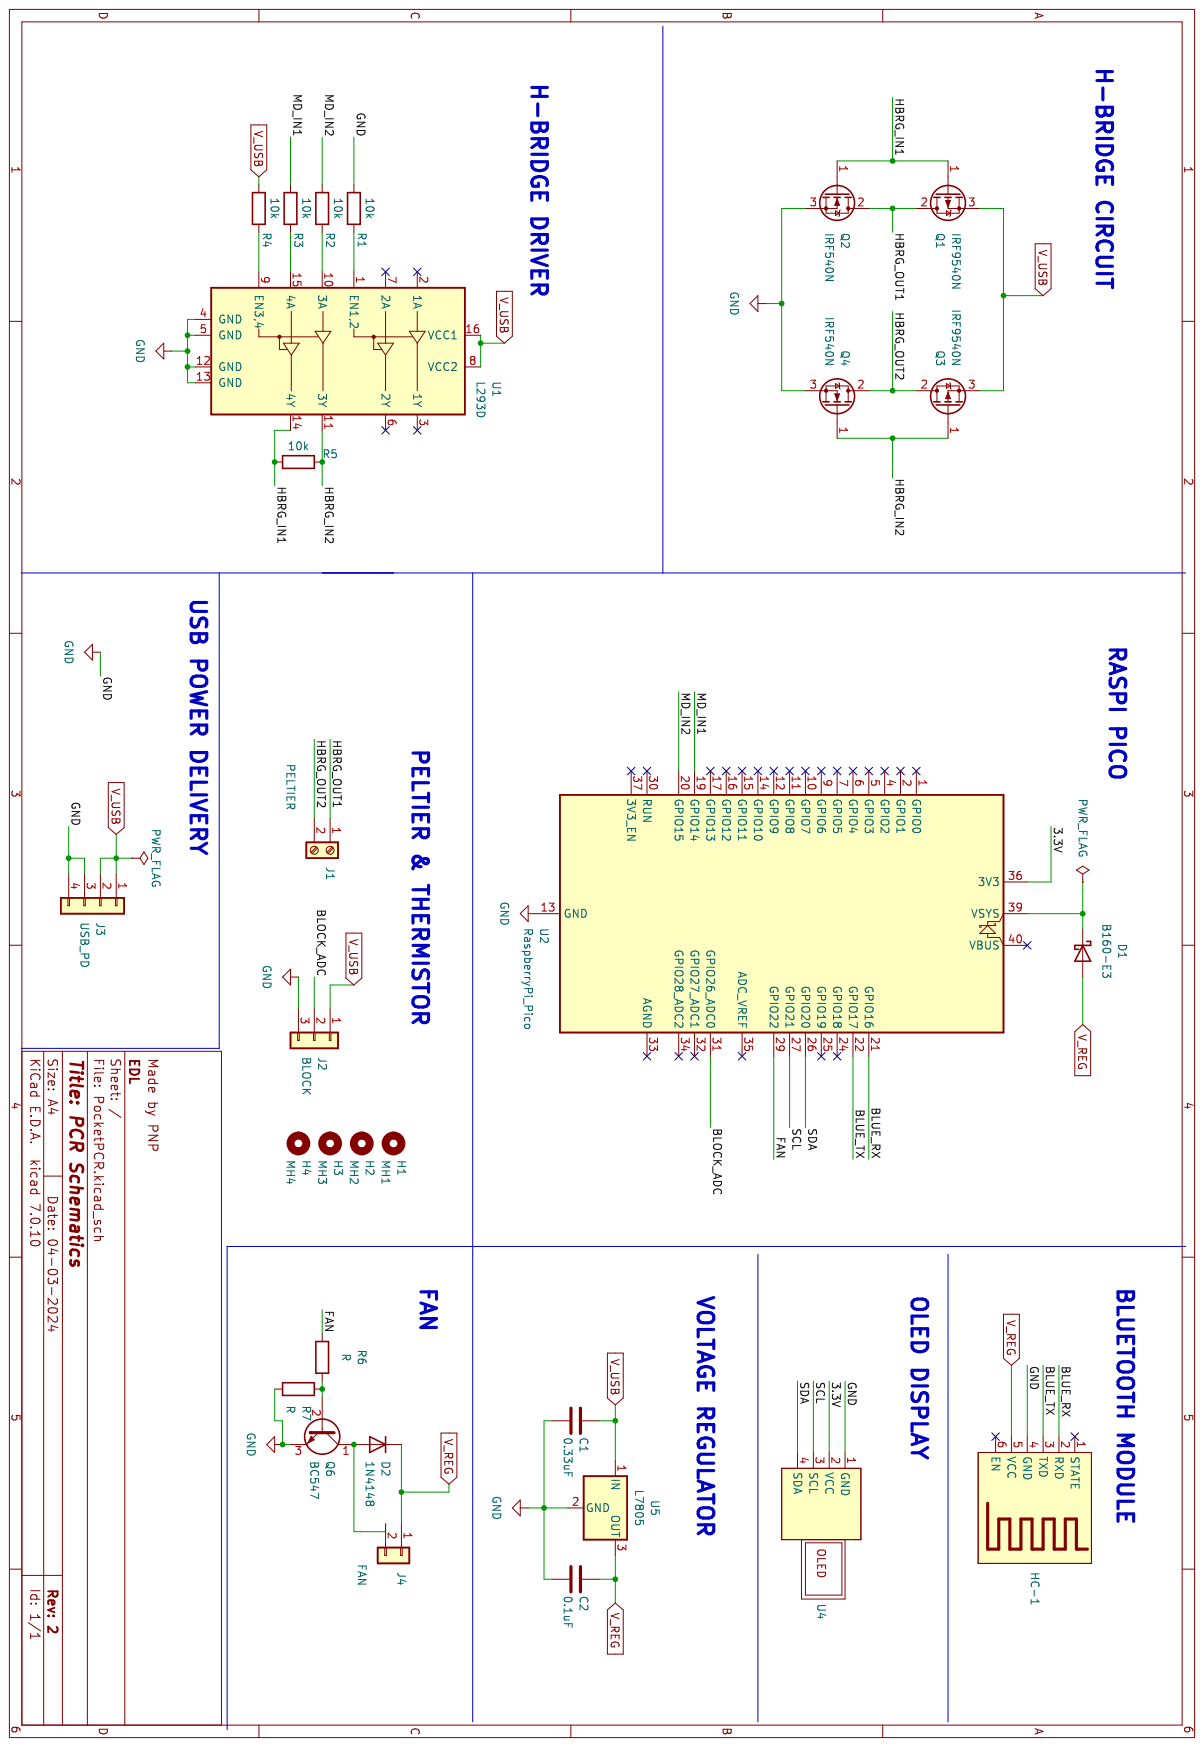
[picture p58: page 1]
