puj24/EDL_TUE16/(commit log)

2024-02-19 Add Schematics for Review
    Schematics Revision 1. Made by PNP
    [PCR-Schematics.kicad_pcb, PCR-Schematics.kicad_sch]
2024-03-13 Add Milestone2 Schematics
    [PocketPCR.kicad_pcb, PocketPCR.kicad_sch]
2024-03-26 gerbers, vias
    [PCR-Schematics.kicad_pcb, PCR-Schematics.kicad_sch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]
2024-03-26 Add PID Code
    PWM part isn't checked
2024-04-01 Add PID codes & results
    Arduino codes & results
2024-04-03 PCB Version 4
    [PocketPCR.kicad_pcb, PocketPCR.kicad_sch]
2024-04-10 PID code & results
2024-04-13 Workinh PID code .c
2024-06-16 Update reports
    [PCR_Heater v4.f3d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]
